danstg1/DAVE-Light/images/dave-cloud.jpeg

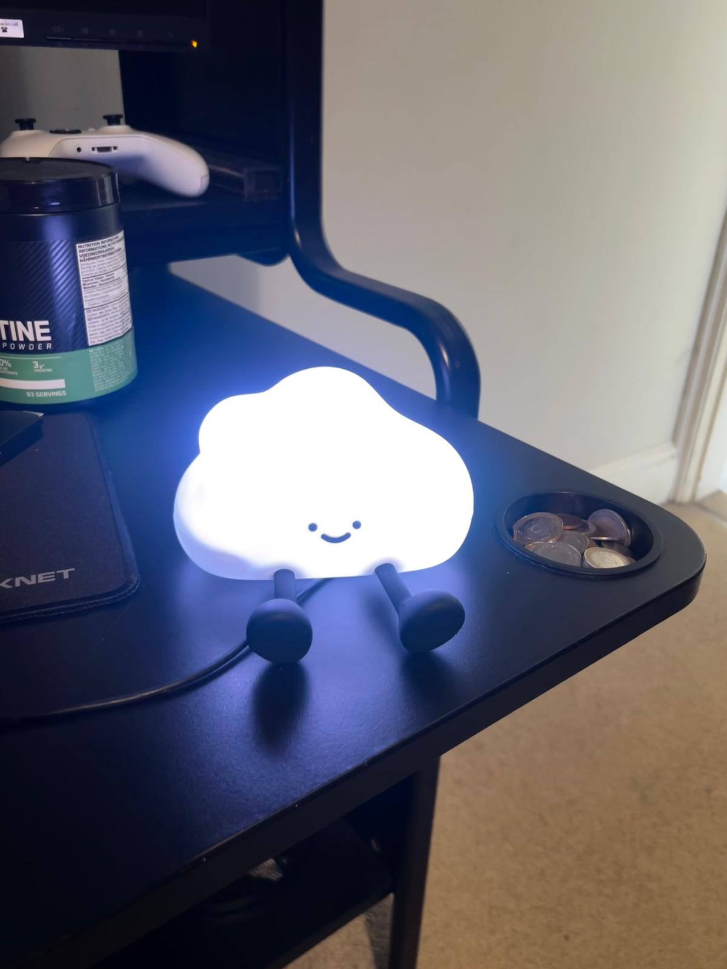
images/dave-cloud.jpeg
