danstg1/DAVE-Light/images/dave-solo.jpeg

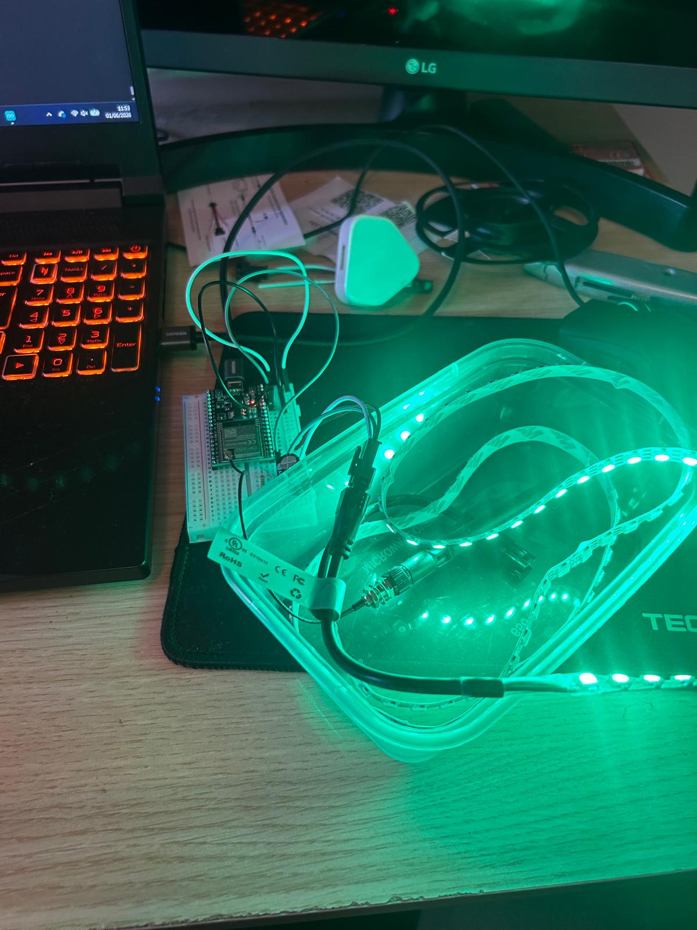
images/dave-solo.jpeg
