danstg1/DAVE-Light/images/davedesign.png

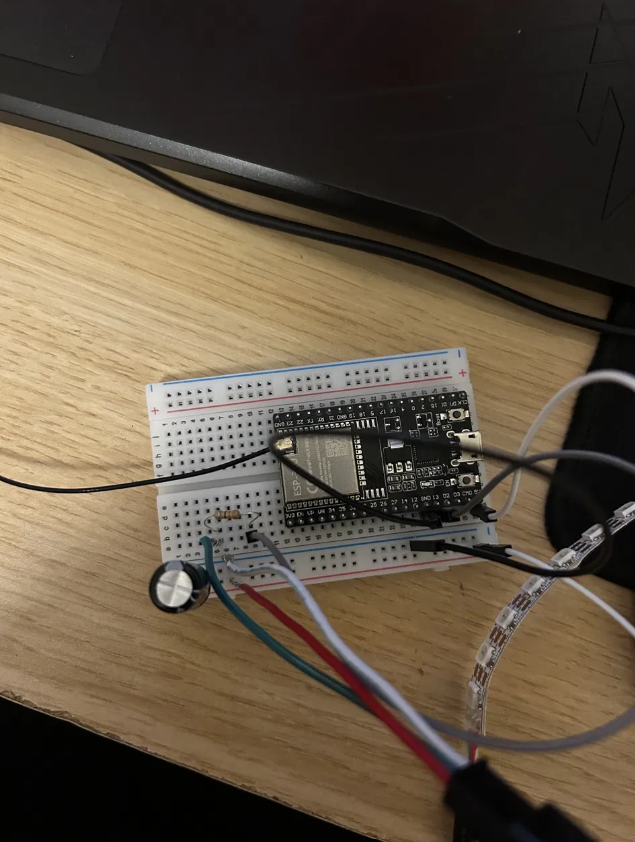
images/davedesign.png
