danstg1/DAVE-Light/(commit log)

2026-07-04 Add initial implementation of DAVE glucose mood light
    Initial commit of DAVE, a glucose mood light that changes color based on blood glucose readings from a FreeStyle Libre 2 Plus sensor. Includes setup for ESP32, LED strip, and WiFi connectivity.
2026-07-07 Adjust image dimensions in README
    Updated image sizes for clarity in wiring section.
2026-07-07 Adjust images and add wiring diagram in README
    Updated image sizes and added a diagram for clarity.
